Arcraith/LEDVentilator/README.md

# LEDVentilator

Das Projekt LEDVentilator im Fach MOSY/ITS wird die optische Illusion "Persistence of vision" anhand eines mit LEDs bestückten Ventilator behandeln.

Ziel dabei ist die Ausgabe von Text auf dem vom Ventilator erzeugten "Display" und die manuelle Eingabe von Text durch den User.

Teilnehmer: Friedrich, Nora, Ann-Kathrin, Tobias
