Arcraith/LEDVentilator/Plakat/README.md

# Plakat

Das Plakat, welches auf der Ausstellung ausgestellt wird.
