Arcraith/LEDVentilator/Source/Website/README.md

# Web-Applikation zum Projekt

In diesem Ordner liegen die Bestandteile der Web-Applikation aufgeteilt in Server und Public. Struktur basiert auf der im Kurs besprochenen Struktur, die einzelnen Projekten einen eigenen Namespace zuordnet.

Insgesamt gibt es 3 Webseiten:
* Hauptseite, in der das hauptsächliche Feature (Bildauswahl) stattfindet
* Testseite doodleIO: gemeinesames Malen wird hier getestet
* Testseite textinput: eine Warteschlange an Texteingaben und Darstellung
