Arcraith/LEDVentilator/Plakat/led_rotor_plakat.pdf

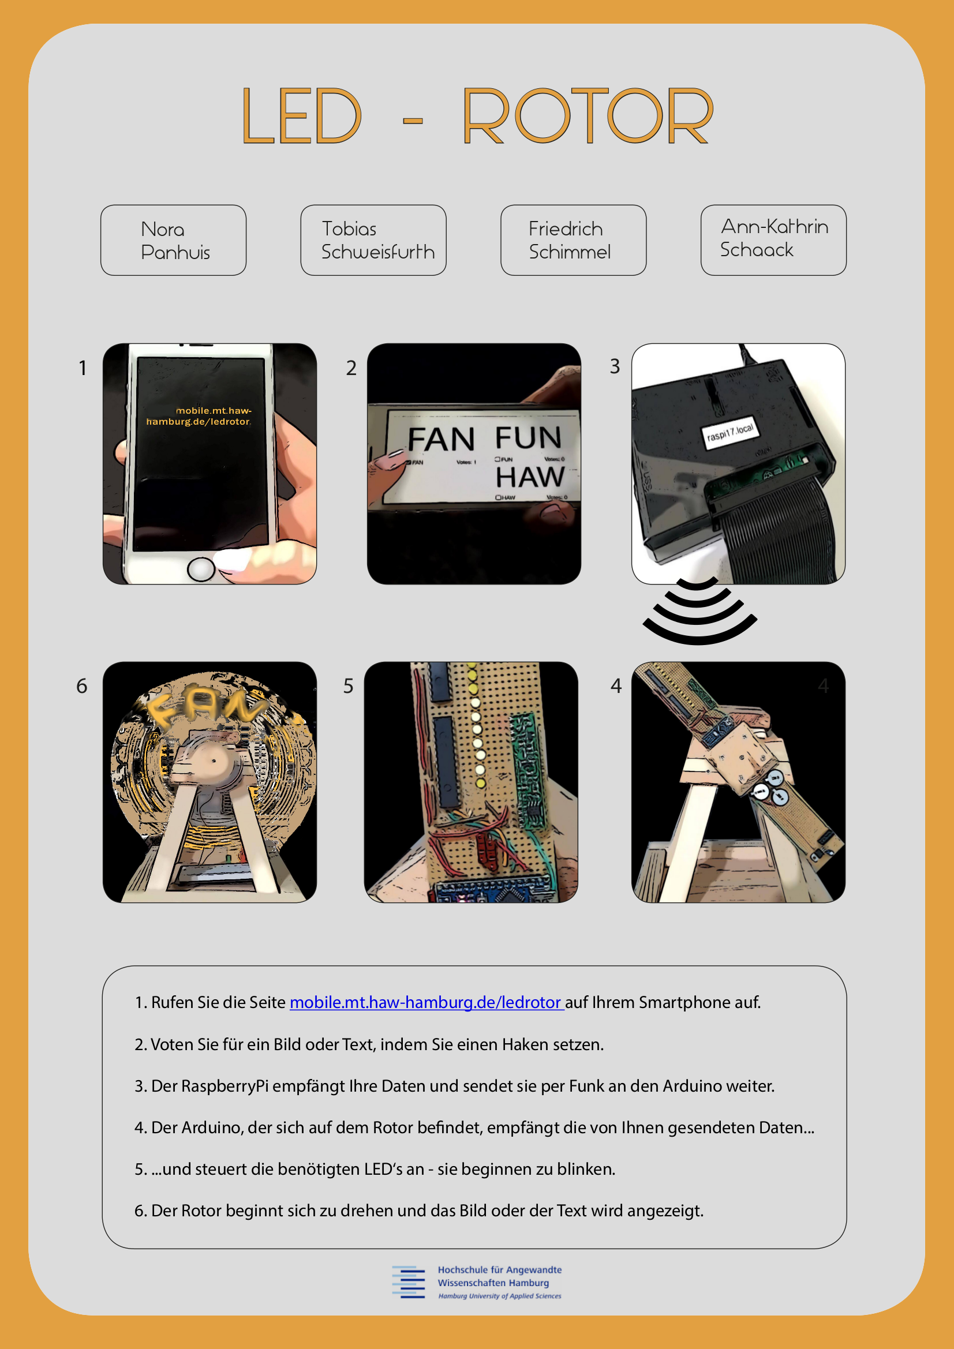
[picture p3: page 1]
