Arcraith/LEDVentilator/Schaltplan/schaltplan_led-rotor.jpg

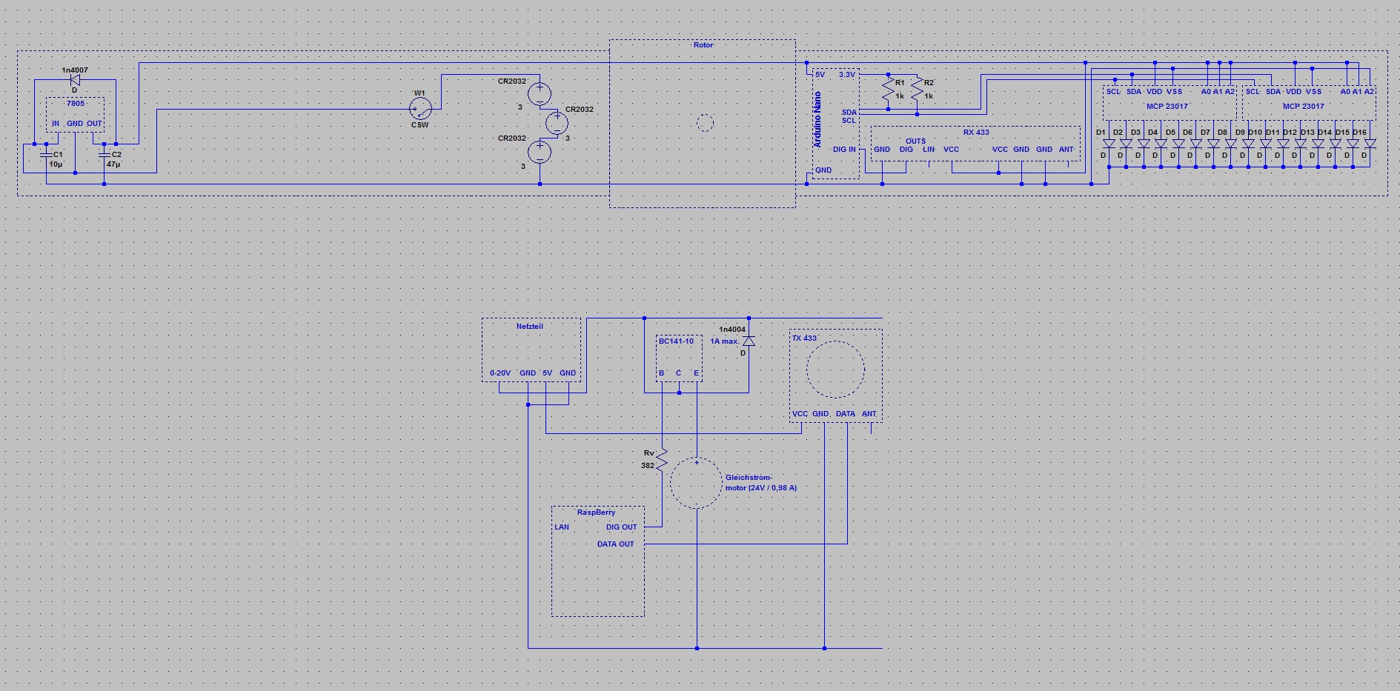
Schaltplan/schaltplan_led-rotor.jpg
