Arcraith/LEDVentilator/Source/Website/641x641.png

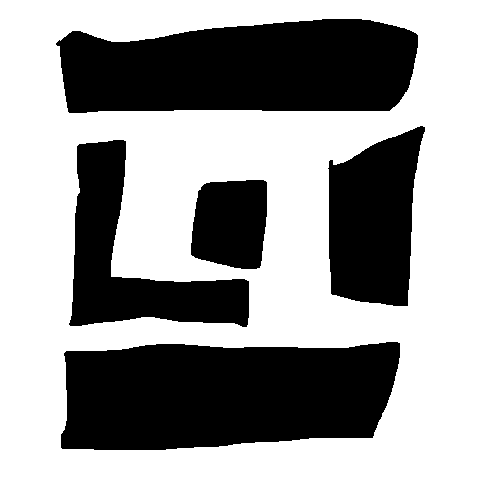
Source/Website/641x641.png
