Arcraith/LEDVentilator/Source/Website/images/image.png

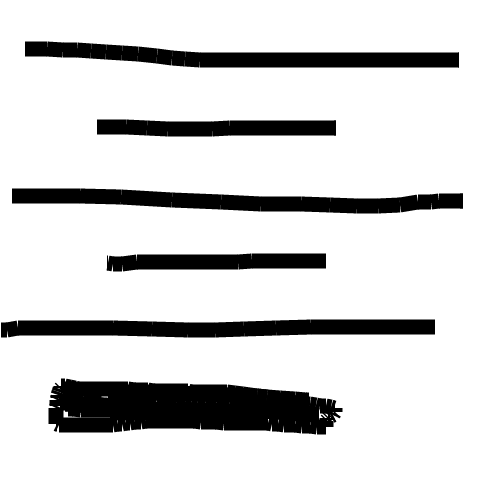
Source/Website/images/image.png
