Arcraith/LEDVentilator/Source/Arduino/Testprogramme/README.md

# Arduino Testprogramme

In diesem Ordner liegen einzele Arduino-Sketches, die geschrieben wurden, um einzelne Funktionen zu testen.

In ungefährer Reihenfolge sollten folgende Funktionen getestet werden:
* Funkverbindung zwischen RaspberryPi und Arduino -> eine LED anmachen.
* Funkverbindung zwischen RaspberryPi und Arduino -> auf bestimmte Zahl reagieren und dementsprechend LEDs mit Expandern anschalten
* TimerOne Library testen für Bilddarstellung durch Interrupts
* Testen des Reed-Kontakts -> Zählen von Runden
* Bildstabilisierung durch Reedkontakt -> Setzen der Timer-Interrupt Periode

Diese Programme können dann später teilweise zusammengefügt werden.
