Arcraith/LEDVentilator/(commit log)

2016-05-11 add client-website prototype, add server prototype
2016-06-21 add arduino test-sketches
2016-06-21 add arduino test-sketches + update current test-sketches
2016-06-22 add arduino sketches for timer-interrupt based picture
2016-06-29 add Description for Arduino Sketches
2016-07-04 update arduino sketches
2016-07-06 add python namespace, motorsteuerung, fixed Server
    [funk.py]
